Bafran/fall-detection-capstone/electrical/esp_module_rev1/symbols/BMP390L/10LGA_2X2X0p75_BOS.step

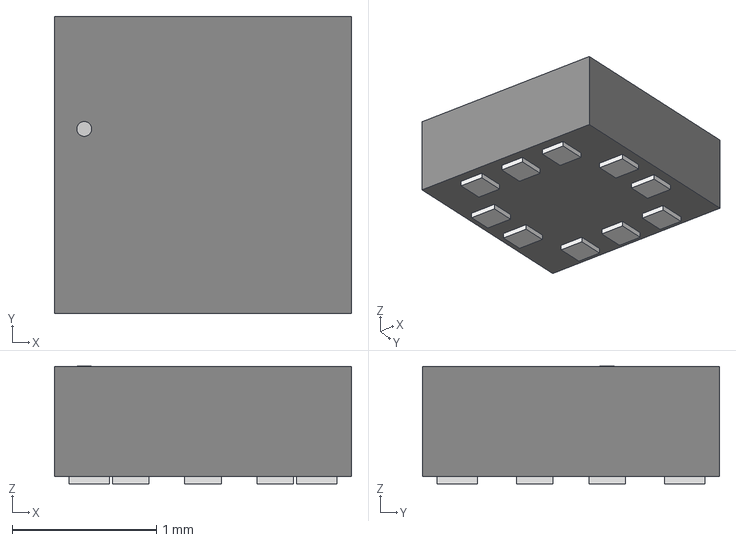
[picture p1: CAD file, 2025-12-22]
electrical/esp_module_rev1/symbols/BMP390L/10LGA_2X2X0p75_BOS.step
2.06 x 2.06 x 0.815 mm
