Bafran/fall-detection-capstone/electrical/symbols/TCK106AF/SMV_z90.stp

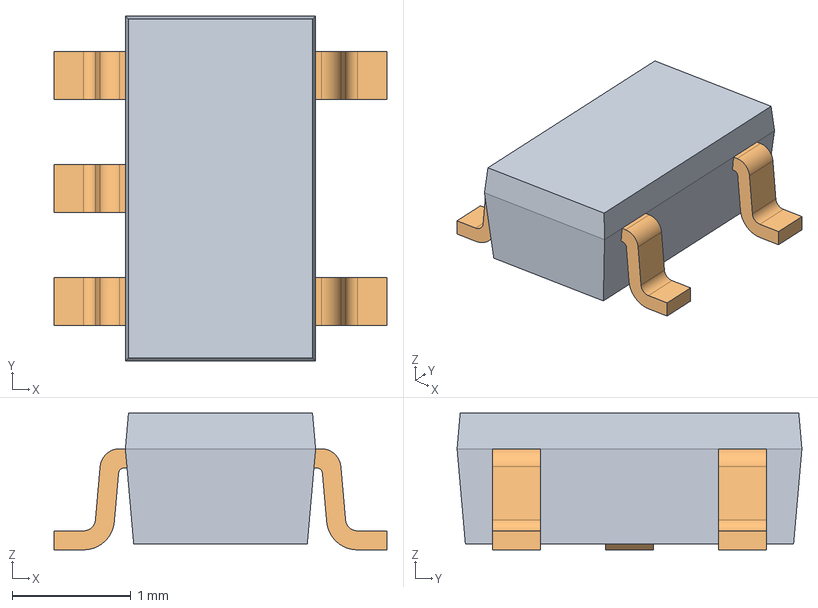
[picture p2: CAD file, 2025-12-19]
electrical/symbols/TCK106AF/SMV_z90.stp
2.80 x 2.90 x 1.15 mm
