Bafran/fall-detection-capstone/electrical/esp_module_rev1/esp_module_rev1/esp_module_rev1.kicad_pcb

## KiCad design electrical/esp_module_rev1/esp_module_rev1/esp_module_rev1.kicad_pcb (2026-01-17)

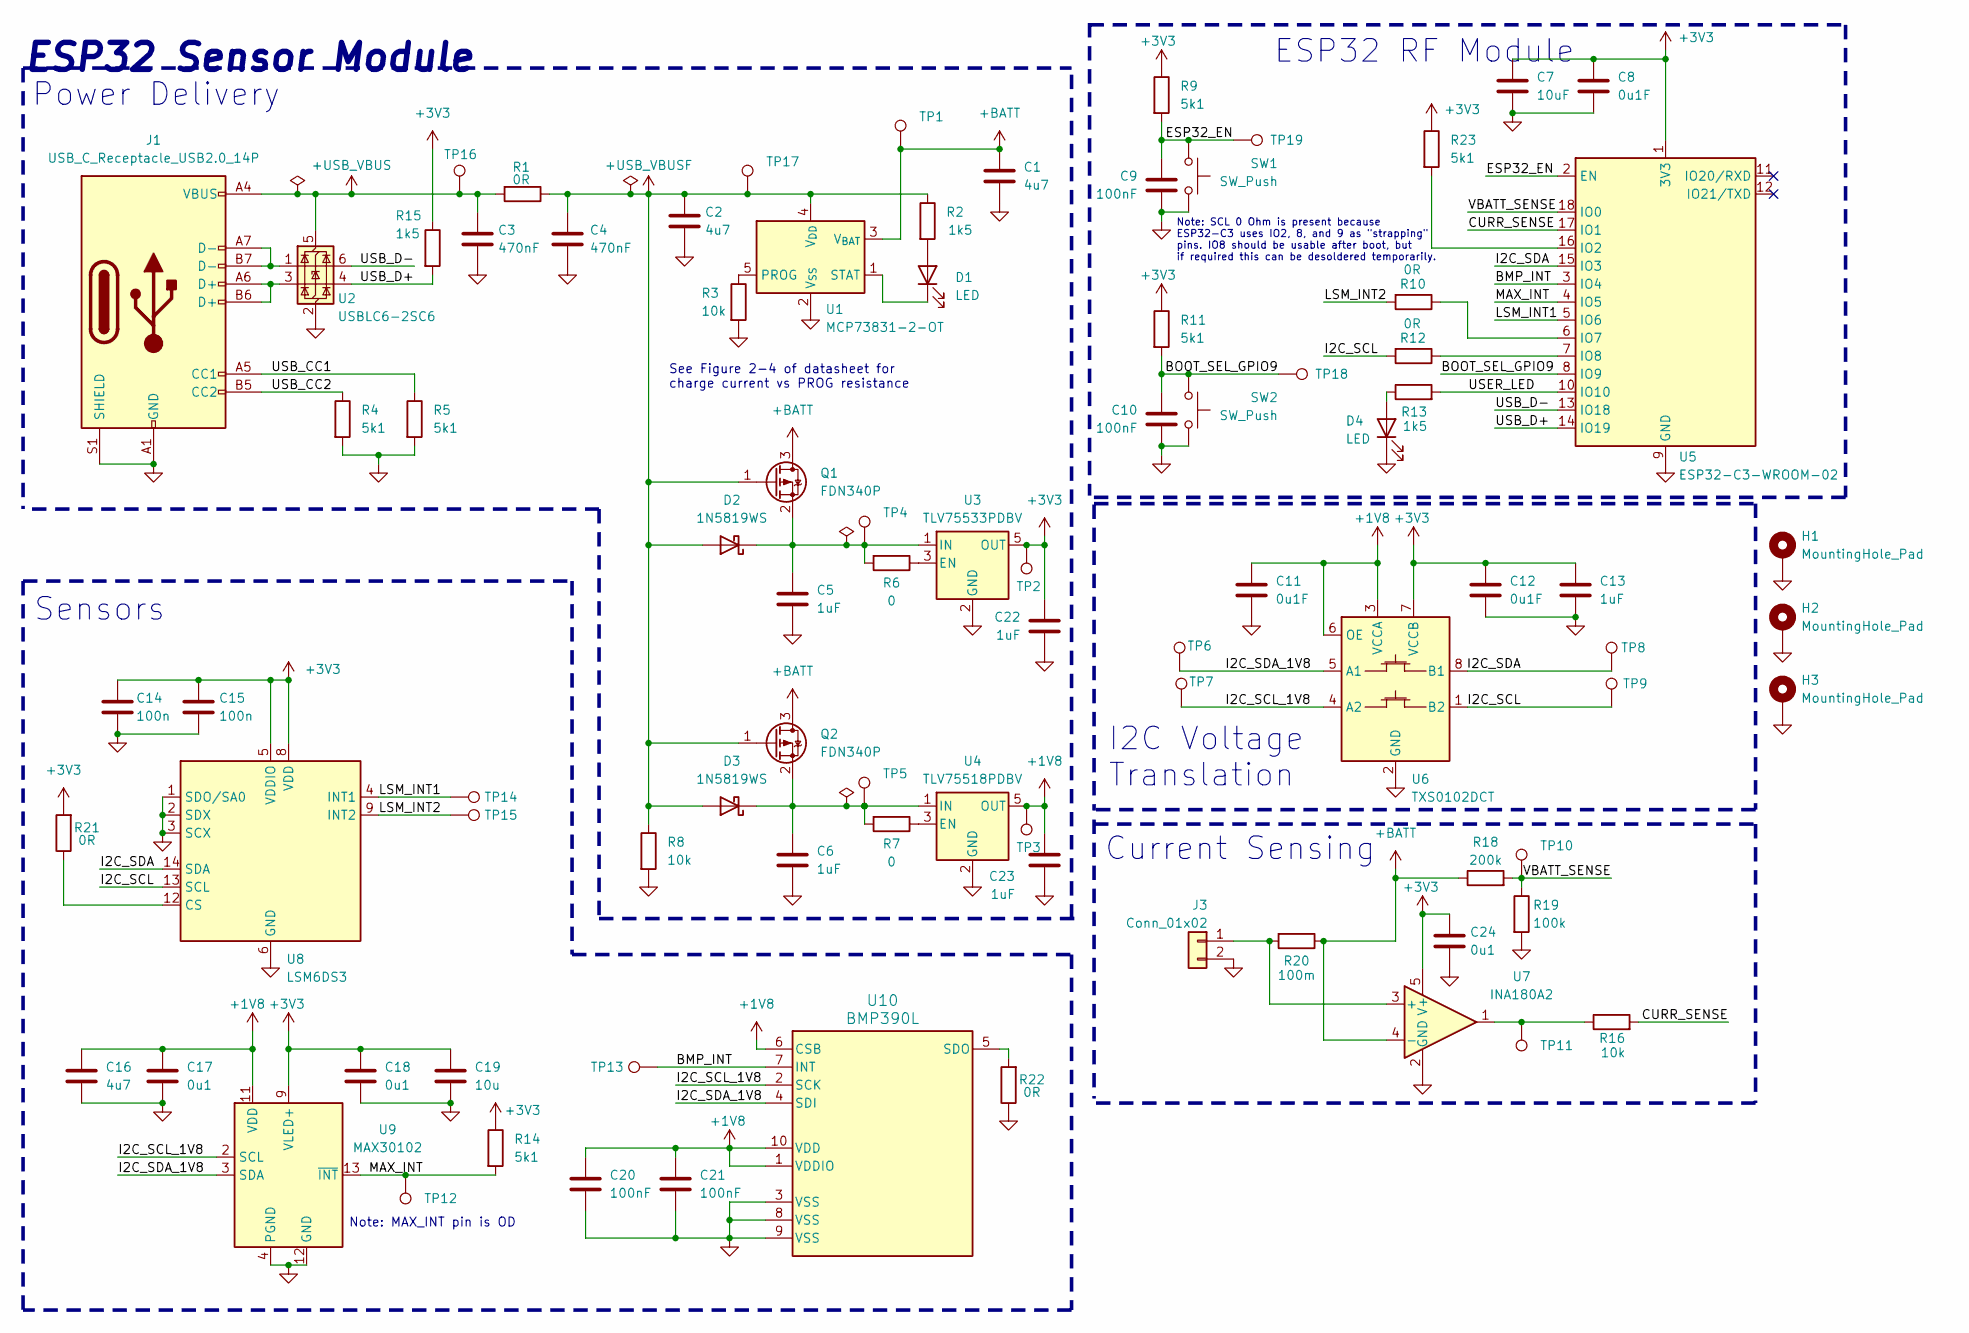
[picture p3: schematic esp_module_rev1.kicad_sch, ESP 32 Sensor Module]

Parts:
C1, C2, C16: 4u7; C_0603_1608Metric_Pad1.08x0.95mm_HandSolder
C3, C4: 470nF; C_0603_1608Metric_Pad1.08x0.95mm_HandSolder
C5, C6, C13, C22, C23: 1uF; C_0603_1608Metric_Pad1.08x0.95mm_HandSolder
C7: 10uF; C_0603_1608Metric_Pad1.08x0.95mm_HandSolder
C8, C11, C12: 0u1F; C_0603_1608Metric_Pad1.08x0.95mm_HandSolder
C9, C10, C20, C21: 100nF; C_0603_1608Metric_Pad1.08x0.95mm_HandSolder
C14, C15: 100n; C_0603_1608Metric_Pad1.08x0.95mm_HandSolder
C17, C18, C24: 0u1; C_0603_1608Metric_Pad1.08x0.95mm_HandSolder
C19: 10u; C_0603_1608Metric_Pad1.08x0.95mm_HandSolder
D1: LED; LED_0805_2012Metric_Pad1.15x1.40mm_HandSolder
D2, D3: 1N5819WS; D_SOD-323
D4: LED; LED_1206_3216Metric_Pad1.42x1.75mm_HandSolder
H1, H2, H3: MountingHole_Pad; MountingHole_2.2mm_M2_Pad_Via
J1: USB_C_Receptacle_USB2.0_14P; USB_C_Receptacle_GCT_USB4105-xx-A_16P_TopMnt_Horizontal
J3: Conn_01x02; JST_PH_B2B-PH-K_1x02_P2.00mm_Vertical
Q1, Q2: FDN340P; SOT-23
R1, R10, R12, R21, R22: 0R; R_0603_1608Metric_Pad0.98x0.95mm_HandSolder
R2, R13, R15: 1k5; R_0603_1608Metric_Pad0.98x0.95mm_HandSolder
R3, R8, R16: 10k; R_0603_1608Metric_Pad0.98x0.95mm_HandSolder
R4, R5, R9, R11, R14, R23: 5k1; R_0603_1608Metric_Pad0.98x0.95mm_HandSolder
R6, R7: 0; R_0603_1608Metric_Pad0.98x0.95mm_HandSolder
R18: 200k; R_0603_1608Metric_Pad0.98x0.95mm_HandSolder
R19: 100k; R_0603_1608Metric_Pad0.98x0.95mm_HandSolder
R20: 100m; R_0603_1608Metric_Pad0.98x0.95mm_HandSolder
SW1, SW2: SW_Push; SW_PUSH_6mm
TP1, TP2, TP3, TP4, TP5, TP6, TP7, TP8, TP9, TP10, TP11, TP12, TP13, TP14, TP15, TP16, TP17, TP18, TP19: TestPoint; TestPoint_THTPad_D1.5mm_Drill0.7mm
U1: MCP73831-2-OT; SOT-23-5
U2: USBLC6-2SC6; SOT-23-6
U3: TLV75533PDBV; SOT-23-5
U4: TLV75518PDBV; SOT-23-5
U5: ESP32-C3-WROOM-02
U6: TXS0102DCT; SSOP-8_2.95x2.8mm_P0.65mm
U7: INA180A2; SOT-23-5
U8: LSM6DS3; LGA-14_3x2.5mm_P0.5mm_LayoutBorder3x4y
U9: MAX30102; Maxim_OLGA-14_3.3x5.6mm_P0.8mm
U10: BMP390L; 10LGA_2X2X0p75_BOS

Connections:
+1V8: C11.1, C16.1, C17.1, C20.1, C21.1, C23.1, TP3.1, U4.5 (OUT), U6.3 (VCCA), U6.6 (OE), U9.11 (VDD), U10.1 (VDDIO), U10.6 (CSB), U10.10 (VDD)
+3V3: C7.1, C8.1, C12.1, C13.1, C14.1, C15.1, C18.1, C19.1, C22.1, C24.1, R9.1, R11.1, R14.1, R15.1, R21.2, R23.1, TP2.1, U3.5 (OUT), U5.1 (3V3), U6.7 (VCCB), U7.5 (V+), U8.5 (VDDIO), U8.8 (VDD), U9.9 (VLED+), U9.10 (VLED+)
+BATT: C1.1, Q1.3 (D), Q2.3 (D), R18.1, R20.1, TP1.1, U1.3 (V_{BAT}), U7.4 (-)
+USB_VBUS: C3.1, J1.A4 (VBUS), J1.A9 (VBUS), J1.B4 (VBUS), J1.B9 (VBUS), R1.2, TP16.1, U2.5 (VBUS)
+USB_VBUSF: C2.1, C4.1, D2.2 (A), D3.2 (A), Q1.1 (G), Q2.1 (G), R1.1, R2.1, R8.1, TP17.1, U1.4 (V_{DD})
/BMP_INT: TP13.1, U5.3 (IO4), U10.7 (INT)
/BOOT_SEL_GPIO9: C10.1, R11.2, SW2.2, TP18.1, U5.8 (IO9)
/CURR_SENSE: R16.2, U5.17 (IO1)
/ESP32_EN: C9.1, R9.2, SW1.2, TP19.1, U5.2 (EN)
/I2C_SCL: R12.2, TP9.1, U6.1 (B2), U8.13 (SCL)
/I2C_SCL_1V8: TP7.1, U6.4 (A2), U9.2 (SCL), U10.2 (SCK)
/I2C_SDA: TP8.1, U5.15 (IO3), U6.8 (B1), U8.14 (SDA)
/I2C_SDA_1V8: TP6.1, U6.5 (A1), U9.3 (SDA), U10.4 (SDI)
/LSM_INT1: TP14.1, U5.5 (IO6), U8.4 (INT1)
/LSM_INT2: R10.2, TP15.1, U8.9 (INT2)
/MAX_INT: R14.2, TP12.1, U5.4 (IO5), U9.13 (~INT)
/USB_CC1: J1.A5 (CC1), R5.1
/USB_CC2: J1.B5 (CC2), R4.1
/USB_D+: R15.2, U2.4 (I/O2), U5.14 (IO19)
/USB_D-: U2.6 (I/O1), U5.13 (IO18)
/USER_LED: R13.2, U5.10 (IO10)
/VBATT_SENSE: R18.2, R19.1, TP10.1, U5.18 (IO0)
GND: C1.2, C2.2, C3.2, C4.2, C5.2, C6.2, C7.2, C8.2, C9.2, C10.2, C11.2, C12.2, C13.2, C14.2, C15.2, C16.2, C17.2, C18.2, C19.2, C20.2, C21.2, C22.2, C23.2, C24.2, D4.1 (K), H1.1, H2.1, H3.1, J1.A1 (GND), J1.A12 (GND), J1.B1 (GND), J1.B12 (GND), J1.S1 (SHIELD), J3.2, R3.2, R4.2, R5.2, R8.2, R19.2, R22.1, SW1.1, SW2.1, U1.2 (V_{SS}), U2.2 (GND), U3.2 (GND), U4.2 (GND), U5.9 (GND), U5.19 (GND), U6.2 (GND), U7.2 (GND), U8.1 (SDO/SA0), U8.2 (SDX), U8.3 (SCX), U8.6 (GND), U8.7 (GND), U9.4 (PGND), U9.12 (GND), U10.3 (VSS), U10.8 (VSS), U10.9 (VSS)
unnamed: D1.2 (A), R2.2
unnamed: D1.1 (K), U1.1 (STAT)
unnamed: C5.1, D2.1 (K), Q1.2 (S), R6.2, TP4.1, U3.1 (IN)
unnamed: C6.1, D3.1 (K), Q2.2 (S), R7.2, TP5.1, U4.1 (IN)
unnamed: D4.2 (A), R13.1
unnamed: J1.A6 (D+), J1.B6 (D+), U2.3 (I/O2)
unnamed: J1.A7 (D-), J1.B7 (D-), U2.1 (I/O1)
unnamed: J3.1, R20.2, U7.3 (+)
unnamed: R16.1, TP11.1, U7.1
unnamed: R3.1, U1.5 (PROG)
unnamed: R6.1, U3.3 (EN)
unnamed: R7.1, U4.3 (EN)
unnamed: R23.2, U5.16 (IO2)
unnamed: R10.1, U5.6 (IO7)
unnamed: R12.1, U5.7 (IO8)
unnamed: R21.1, U8.12 (CS)
unnamed: R22.2, U10.5 (SDO)

Notes on the sheet:
Power Delivery
Sensors
Note: SCL 0 Ohm is present because ESP32-C3 uses IO2, 8, and 9 as "strapping" pins. IO8 should be usable after boot, but if required this can be desoldered temporarily.
Note: MAX_INT pin is OD
See Figure 2-4 of datasheet for charge current vs PROG resistance
I2C Voltage Translation
ESP32 RF Module
ESP32 Sensor Module
Current Sensing

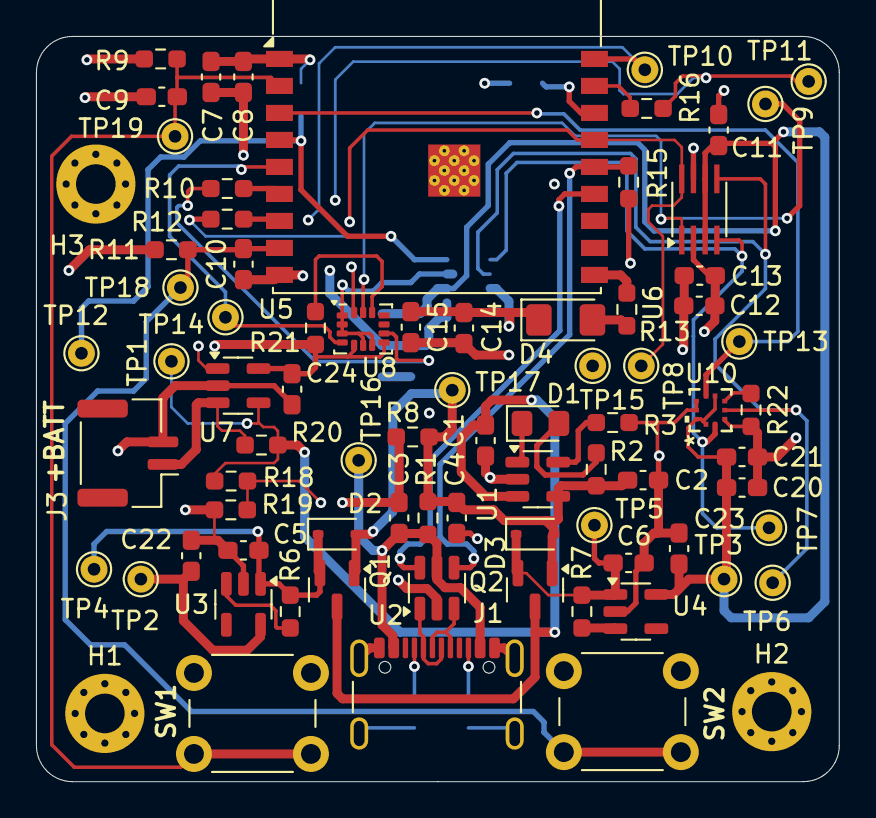
[picture p4: board esp_module_rev1.kicad_pcb from above]

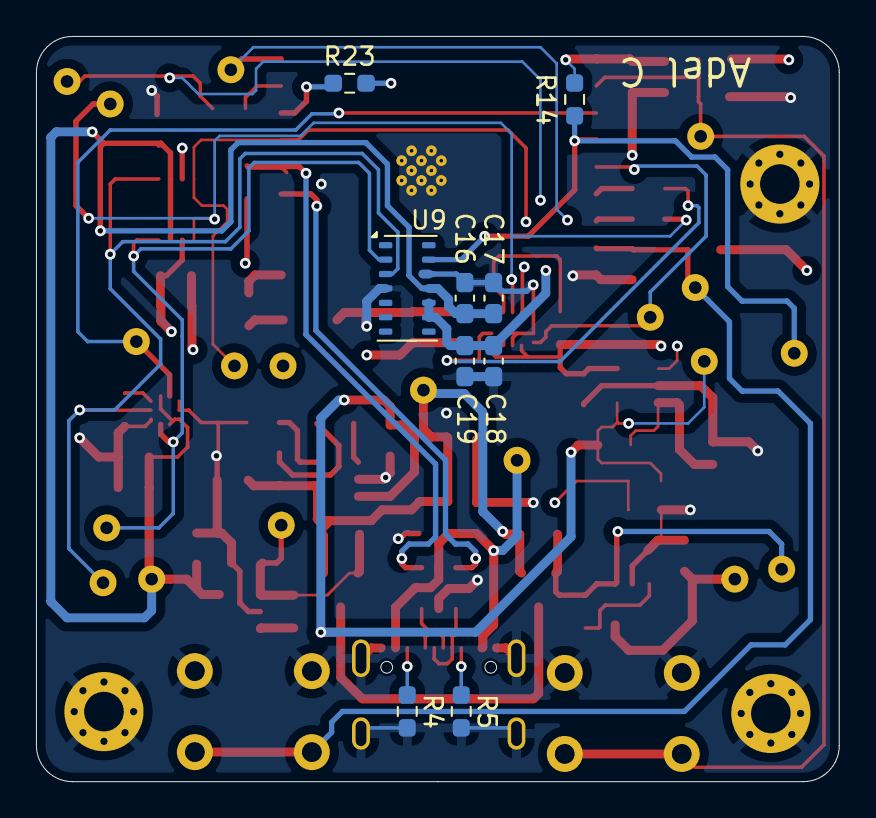
[picture p5: board esp_module_rev1.kicad_pcb from below]

Board: 4 copper layers, 44.6 x 41.4 mm, 88 parts (9 on the bottom side), 40 nets.
