Bafran/fall-detection-capstone/electrical/bracelet_rev1/bracelet_rev1.kicad_pcb

## KiCad design electrical/bracelet_rev1/bracelet_rev1.kicad_pcb (2025-12-21)

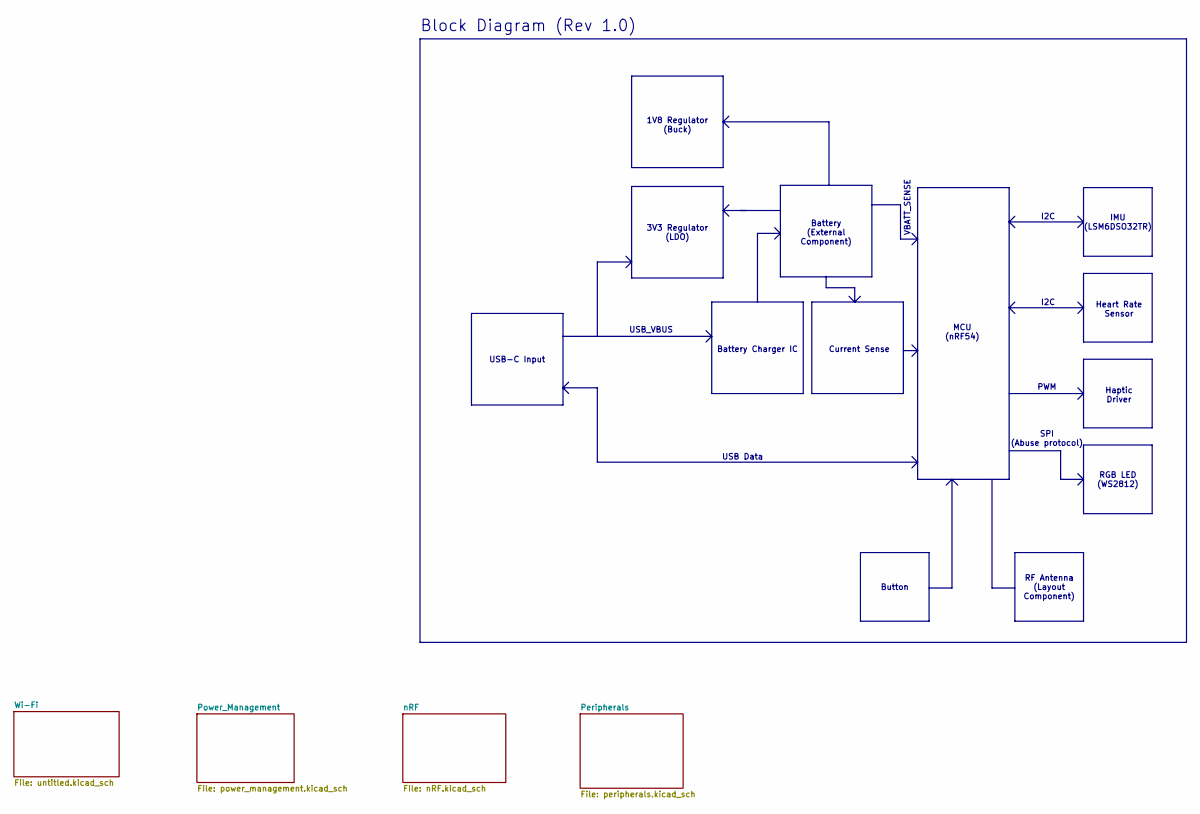
[picture p6: schematic bracelet_rev1.kicad_sch]

Notes on the sheet:
VBATT_SENSE
I2C
3V3 Regulator (LDO)
Haptic Driver
RGB LED (WS2812)
USB Data
Current Sense
IMU (LSM6DSO32TR)
SPI (Abuse protocol)
MCU (nRF54)
USB_VBUS
1V8 Regulator (Buck)
RF Antenna (Layout Component)
Block Diagram (Rev 1.0)
Button
Battery (External Component)
PWM
Battery Charger IC
Heart Rate Sensor
USB-C Input

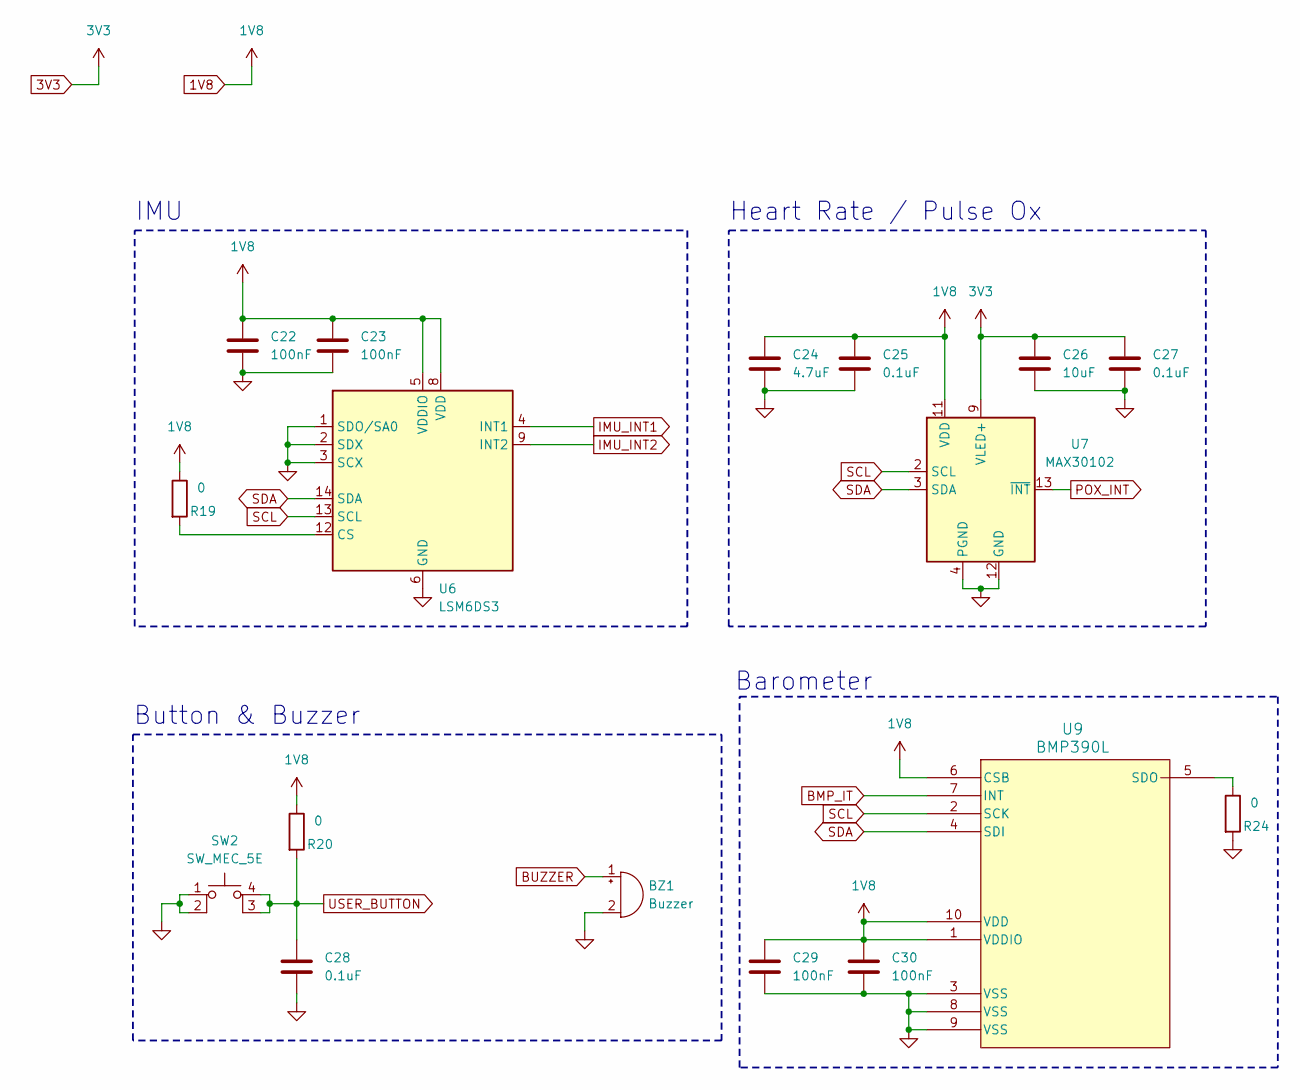
[picture p7: schematic peripherals.kicad_sch]

Parts:
BZ1: Buzzer
C22, C23, C29, C30: 100nF; C_0603_1608Metric_Pad1.08x0.95mm_HandSolder
C24: 4.7uF; C_0603_1608Metric_Pad1.08x0.95mm_HandSolder
C25, C27, C28: 0.1uF; C_0603_1608Metric_Pad1.08x0.95mm_HandSolder
C26: 10uF; C_0603_1608Metric_Pad1.08x0.95mm_HandSolder
R19, R20: 0; R_0603_1608Metric_Pad0.98x0.95mm_HandSolder
R24: 0; R_0201_0603Metric_Pad0.64x0.40mm_HandSolder
SW2: SW_MEC_5E; SW_MEC_5GSH9
U6: LSM6DS3; LGA-14_3x2.5mm_P0.5mm_LayoutBorder3x4y
U7: MAX30102; Maxim_OLGA-14_3.3x5.6mm_P0.8mm
U9: BMP390L

Connections:
3V3: C26.1, C27.1, U7.9 (VLED+), U7.10 (VLED+); also elsewhere on the board
GND: BZ1.2 (-), C22.2, C23.2, C24.2, C25.2, C26.2, C27.2, C28.2, C29.2, C30.2, R24.2, SW2.1, SW2.2, U6.1 (SDO/SA0), U6.2 (SDX), U6.3 (SCX), U6.6 (GND), U6.7 (GND), U7.4 (PGND), U7.12 (GND), U9.3 (VSS), U9.8 (VSS), U9.9 (VSS); also elsewhere on the board
IMU_INT1: U6.4 (INT1); also elsewhere on the board
IMU_INT2: U6.9 (INT2); also elsewhere on the board
unnamed: R19.2, U6.12 (CS)
unnamed: R24.1, U9.5 (SDO)
POX_INT: U7.13 (~INT); also elsewhere on the board
SCL: U6.13 (SCL), U7.2 (SCL), U9.2 (SCK); also elsewhere on the board
SDA: U6.14 (SDA), U7.3 (SDA), U9.4 (SDI); also elsewhere on the board
USER_BUTTON: C28.1, R20.2, SW2.3 (K), SW2.4 (A); also elsewhere on the board

Notes on the sheet:
Button & Buzzer
Heart Rate / Pulse Ox
IMU
Barometer

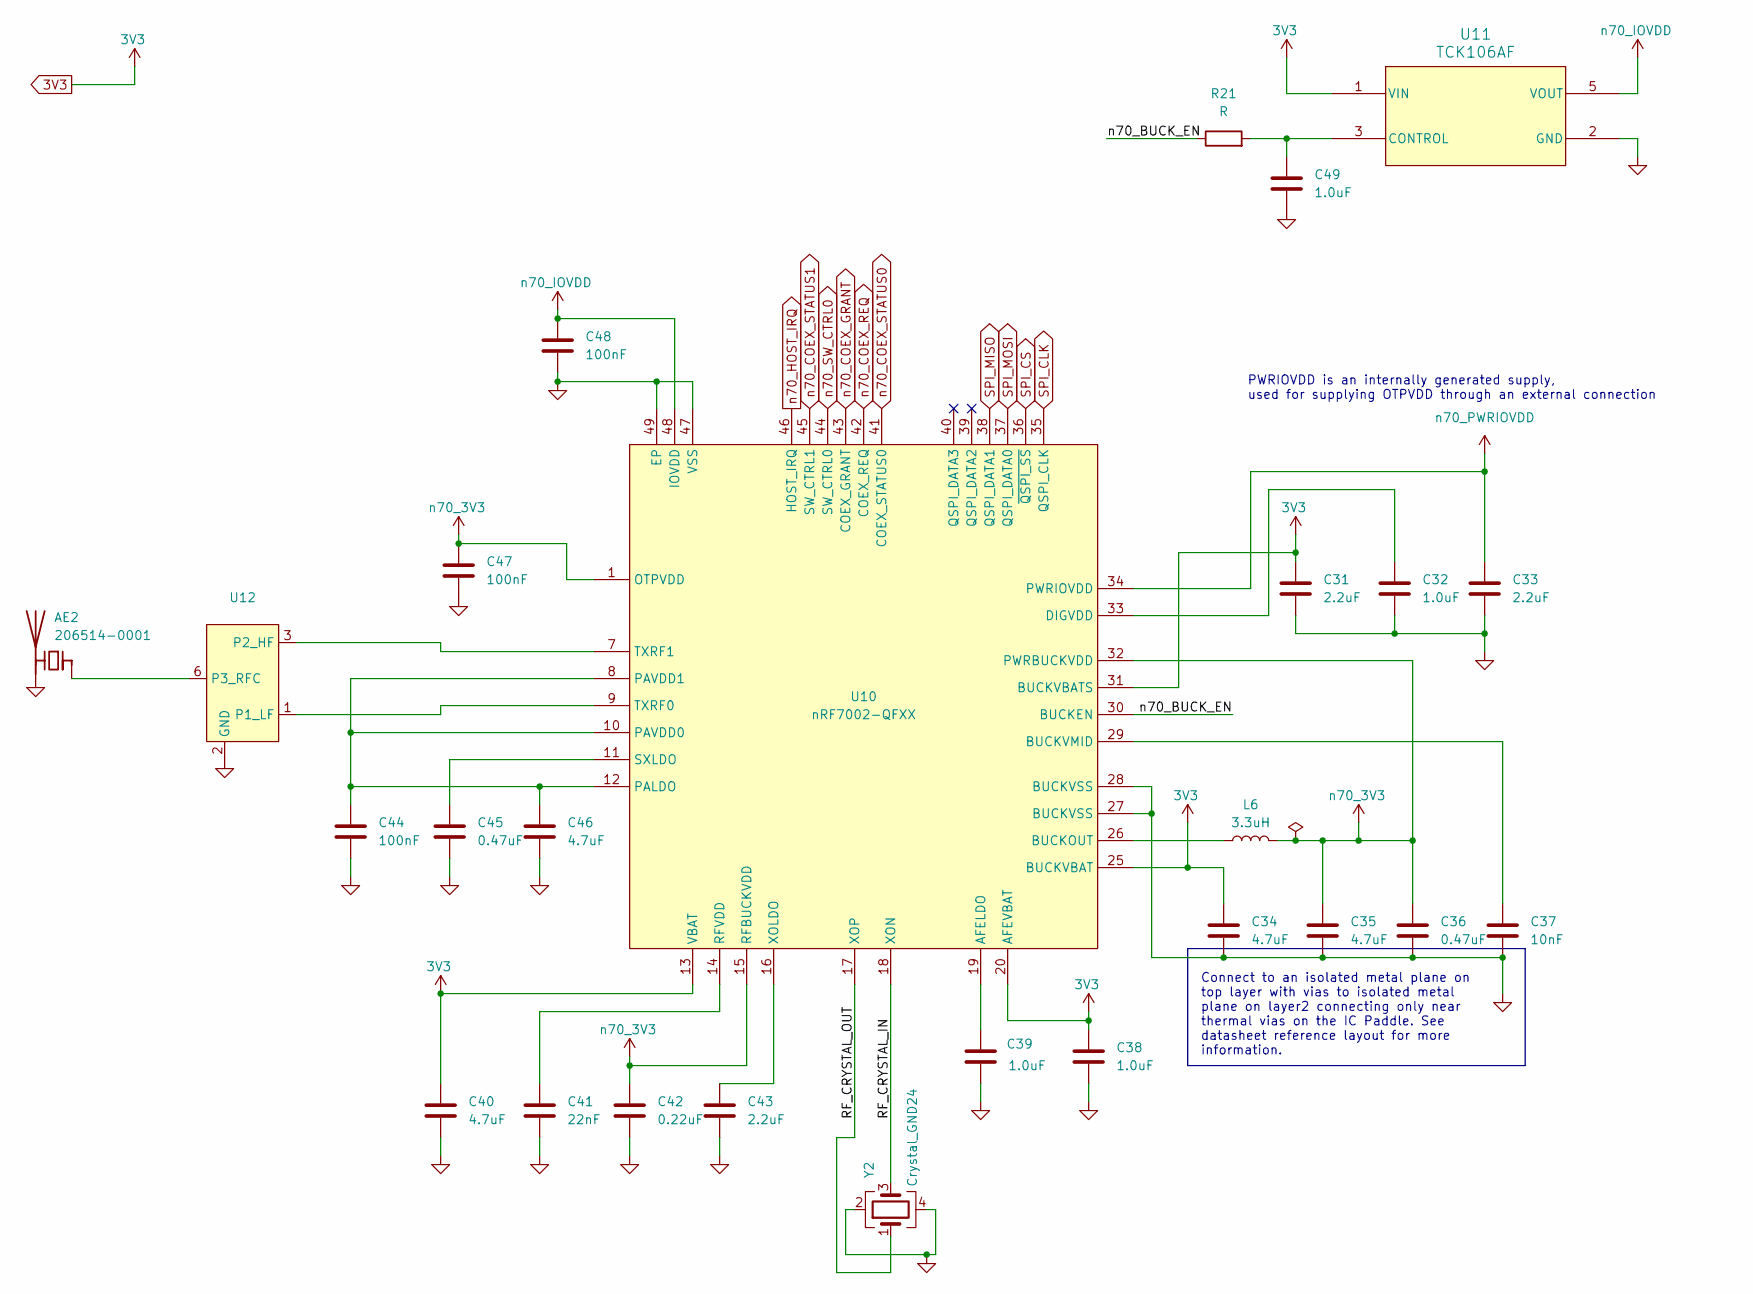
[picture p8: schematic untitled.kicad_sch]

Parts:
AE2: 206514-0001
C31, C33, C43: 2.2uF; C_0603_1608Metric_Pad1.08x0.95mm_HandSolder
C32, C38, C39, C49: 1.0uF; C_0603_1608Metric_Pad1.08x0.95mm_HandSolder
C34, C35, C40, C46: 4.7uF; C_0603_1608Metric_Pad1.08x0.95mm_HandSolder
C36, C45: 0.47uF; C_0603_1608Metric_Pad1.08x0.95mm_HandSolder
C37: 10nF; C_0603_1608Metric_Pad1.08x0.95mm_HandSolder
C41: 22nF; C_0603_1608Metric_Pad1.08x0.95mm_HandSolder
C42: 0.22uF; C_0603_1608Metric_Pad1.08x0.95mm_HandSolder
C44, C47, C48: 100nF; C_0603_1608Metric_Pad1.08x0.95mm_HandSolder
L6: 3.3uH; L_0603_1608Metric_Pad1.05x0.95mm_HandSolder
R21: R; R_0201_0603Metric_Pad0.64x0.40mm_HandSolder
U10: nRF7002-QFXX; QFN-48-1EP_6x6mm_P0.4mm_EP4.6x4.6mm_ThermalVias
U11: TCK106AF
U12: (no value)
Y2: Crystal_GND24; Crystal_SMD_3225-4Pin_3.2x2.5mm_HandSoldering

Connections:
3V3: C31.1, C34.1, C38.1, C40.1, U10.13 (VBAT), U10.20 (AFEVBAT), U10.25 (BUCKVBAT), U10.31 (BUCKVBATS), U11.1 (VIN); also elsewhere on the board
/Wi-Fi/RF_CRYSTAL_IN: U10.18 (XON), Y2.3
/Wi-Fi/RF_CRYSTAL_OUT: U10.17 (XOP), Y2.1
/Wi-Fi/n70_BUCK_EN: R21.1, U10.30 (BUCKEN)
GND: AE2.2 (PCB_Trace), C31.2, C32.2, C33.2, C34.2, C35.2, C36.2, C37.2, C38.2, C39.2, C40.2, C41.2, C42.2, C43.2, C44.2, C45.2, C46.2, C47.2, C48.2, C49.2, U10.27 (BUCKVSS), U10.28 (BUCKVSS), U10.47 (VSS), U10.49 (EP), U11.2 (GND), U12.2 (GND), U12.5 (GND), U12.7 (GND), Y2.2, Y2.4; also elsewhere on the board
unnamed: AE2.1 (FEED), U12.6 (P3_RFC)
unnamed: C39.1, U10.19 (AFELDO)
unnamed: L6.1, U10.26 (BUCKOUT)
unnamed: C37.1, U10.29 (BUCKVMID)
unnamed: C32.1, U10.33 (DIGVDD)
unnamed: C44.1, C46.1, U10.8 (PAVDD1), U10.10 (PAVDD0), U10.12 (PALDO)
unnamed: C41.1, U10.14 (RFVDD)
unnamed: C45.1, U10.11 (SXLDO)
unnamed: U10.9 (TXRF0), U12.1 (P1_LF)
unnamed: U10.7 (TXRF1), U12.3 (P2_HF)
unnamed: C43.1, U10.16 (XOLDO)
unnamed: C49.1, R21.2, U11.3 (CONTROL)
SPI_CLK: U10.35 (QSPI_CLK); also elsewhere on the board
SPI_CS: U10.36 (~QSPI_SS); also elsewhere on the board
SPI_MISO: U10.38 (QSPI_DATA1); also elsewhere on the board
SPI_MOSI: U10.37 (QSPI_DATA0); also elsewhere on the board
n70_3V3: C35.1, C36.1, C42.1, C47.1, L6.2, U10.1 (OTPVDD), U10.15 (RFBUCKVDD), U10.32 (PWRBUCKVDD)
n70_COEX_GRANT: U10.43 (COEX_GRANT); also elsewhere on the board
n70_COEX_REQ: U10.42 (COEX_REQ); also elsewhere on the board
n70_COEX_STATUS0: U10.41 (COEX_STATUS0); also elsewhere on the board
n70_COEX_STATUS1: U10.45 (SW_CTRL1); also elsewhere on the board
n70_HOST_IRQ: U10.46 (HOST_IRQ); also elsewhere on the board
n70_IOVDD: C48.1, U10.48 (IOVDD), U11.5 (VOUT)
n70_PWRIOVDD: C33.1, U10.34 (PWRIOVDD)
n70_SW_CTRL0: U10.44 (SW_CTRL0); also elsewhere on the board

Notes on the sheet:
PWRIOVDD is an internally generated supply, used for supplying OTPVDD through an external connection
Connect to an isolated metal plane on top layer with vias to isolated metal plane on layer2 connecting only near thermal vias on the IC Paddle. See datasheet reference layout for more information.

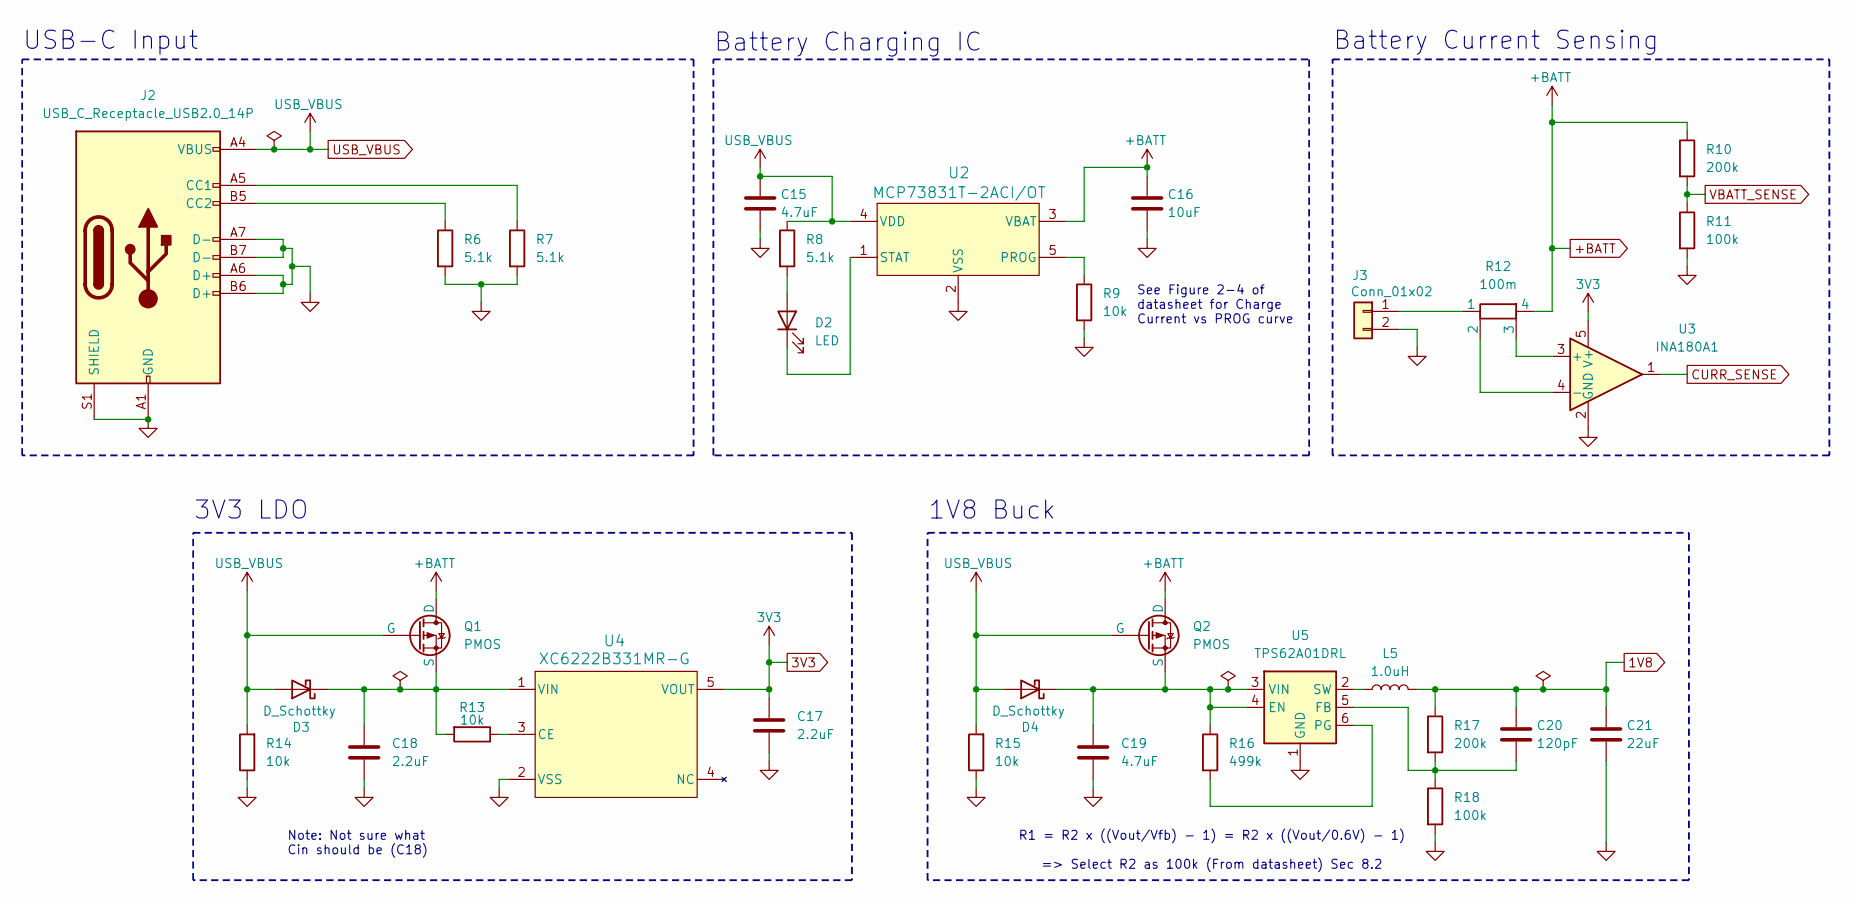
[picture p9: schematic power_management.kicad_sch]

Parts:
C15, C19: 4.7uF; C_0603_1608Metric_Pad1.08x0.95mm_HandSolder
C16: 10uF; C_0603_1608Metric_Pad1.08x0.95mm_HandSolder
C17, C18: 2.2uF; C_0603_1608Metric_Pad1.08x0.95mm_HandSolder
C20: 120pF; C_0603_1608Metric_Pad1.08x0.95mm_HandSolder
C21: 22uF; C_0603_1608Metric_Pad1.08x0.95mm_HandSolder
D2: LED; LED_0603_1608Metric_Pad1.05x0.95mm_HandSolder
D3, D4: D_Schottky; D_0603_1608Metric_Pad1.05x0.95mm_HandSolder
J2: USB_C_Receptacle_USB2.0_14P
J3: Conn_01x02; JST_PH_B2B-PH-K_1x02_P2.00mm_Vertical
L5: 1.0uH; L_0603_1608Metric_Pad1.05x0.95mm_HandSolder
Q1, Q2: PMOS; SOT-23-3
R6, R7, R8: 5.1k; R_0603_1608Metric_Pad0.98x0.95mm_HandSolder
R9, R13, R14, R15: 10k; R_0603_1608Metric_Pad0.98x0.95mm_HandSolder
R10, R17: 200k; R_0603_1608Metric_Pad0.98x0.95mm_HandSolder
R11, R18: 100k; R_0603_1608Metric_Pad0.98x0.95mm_HandSolder
R12: 100m; R_Shunt_Ohmite_LVK12
R16: 499k; R_0603_1608Metric_Pad0.98x0.95mm_HandSolder
U2: MCP73831T-2ACI/OT
U3: INA180A1; SOT-23-5
U4: XC6222B331MR-G
U5: TPS62A01DRL; SOT-563

Connections:
3V3: C17.1, U2.6 (V_{CCB}), U3.5 (V+), U4.5 (VOUT); also elsewhere on the board
CURR_SENSE: U3.1; also elsewhere on the board
GND: C15.2, C16.2, C17.2, C18.2, C19.2, C21.2, J2.A1 (GND), J2.A6 (D+), J2.A7 (D-), J2.A12 (GND), J2.B1 (GND), J2.B6 (D+), J2.B7 (D-), J2.B12 (GND), J2.S1 (SHIELD), J3.2, R6.2, R7.2, R9.2, R11.2, R14.1, R15.1, R18.2, U2.2 (GND), U3.2 (GND), U4.2 (VSS), U5.1 (GND); also elsewhere on the board
unnamed: D2.2 (A), R8.2
unnamed: C18.1, D3.1 (K), Q1.3 (S), R13.2, U4.1 (VIN)
unnamed: C19.1, D4.1 (K), Q2.3 (S), R16.1, U5.3 (VIN), U5.4 (EN)
unnamed: J2.A5 (CC1), R7.1
unnamed: J2.B5 (CC2), R6.1
unnamed: J3.1, R12.1
unnamed: R12.3, U3.3 (+)
unnamed: R12.2, U3.4 (-)
unnamed: R13.1, U4.3 (CE)
unnamed: C20.2, R17.2, R18.1, U5.5 (FB)
unnamed: R16.2, U5.6 (PG)
unnamed: L5.1, U5.2 (SW)
VBATT_SENSE: R10.2, R11.1; also elsewhere on the board

Notes on the sheet:
R1 = R2 x ((Vout/Vfb) - 1) = R2 x ((Vout/0.6V) - 1) => Select R2 as 100k (From datasheet) Sec 8.2
Note: Not sure what Cin should be (C18)
See Figure 2-4 of datasheet for Charge Current vs PROG curve
3V3 LDO
1V8 Buck
Battery Current Sensing
USB-C Input
Battery Charging IC

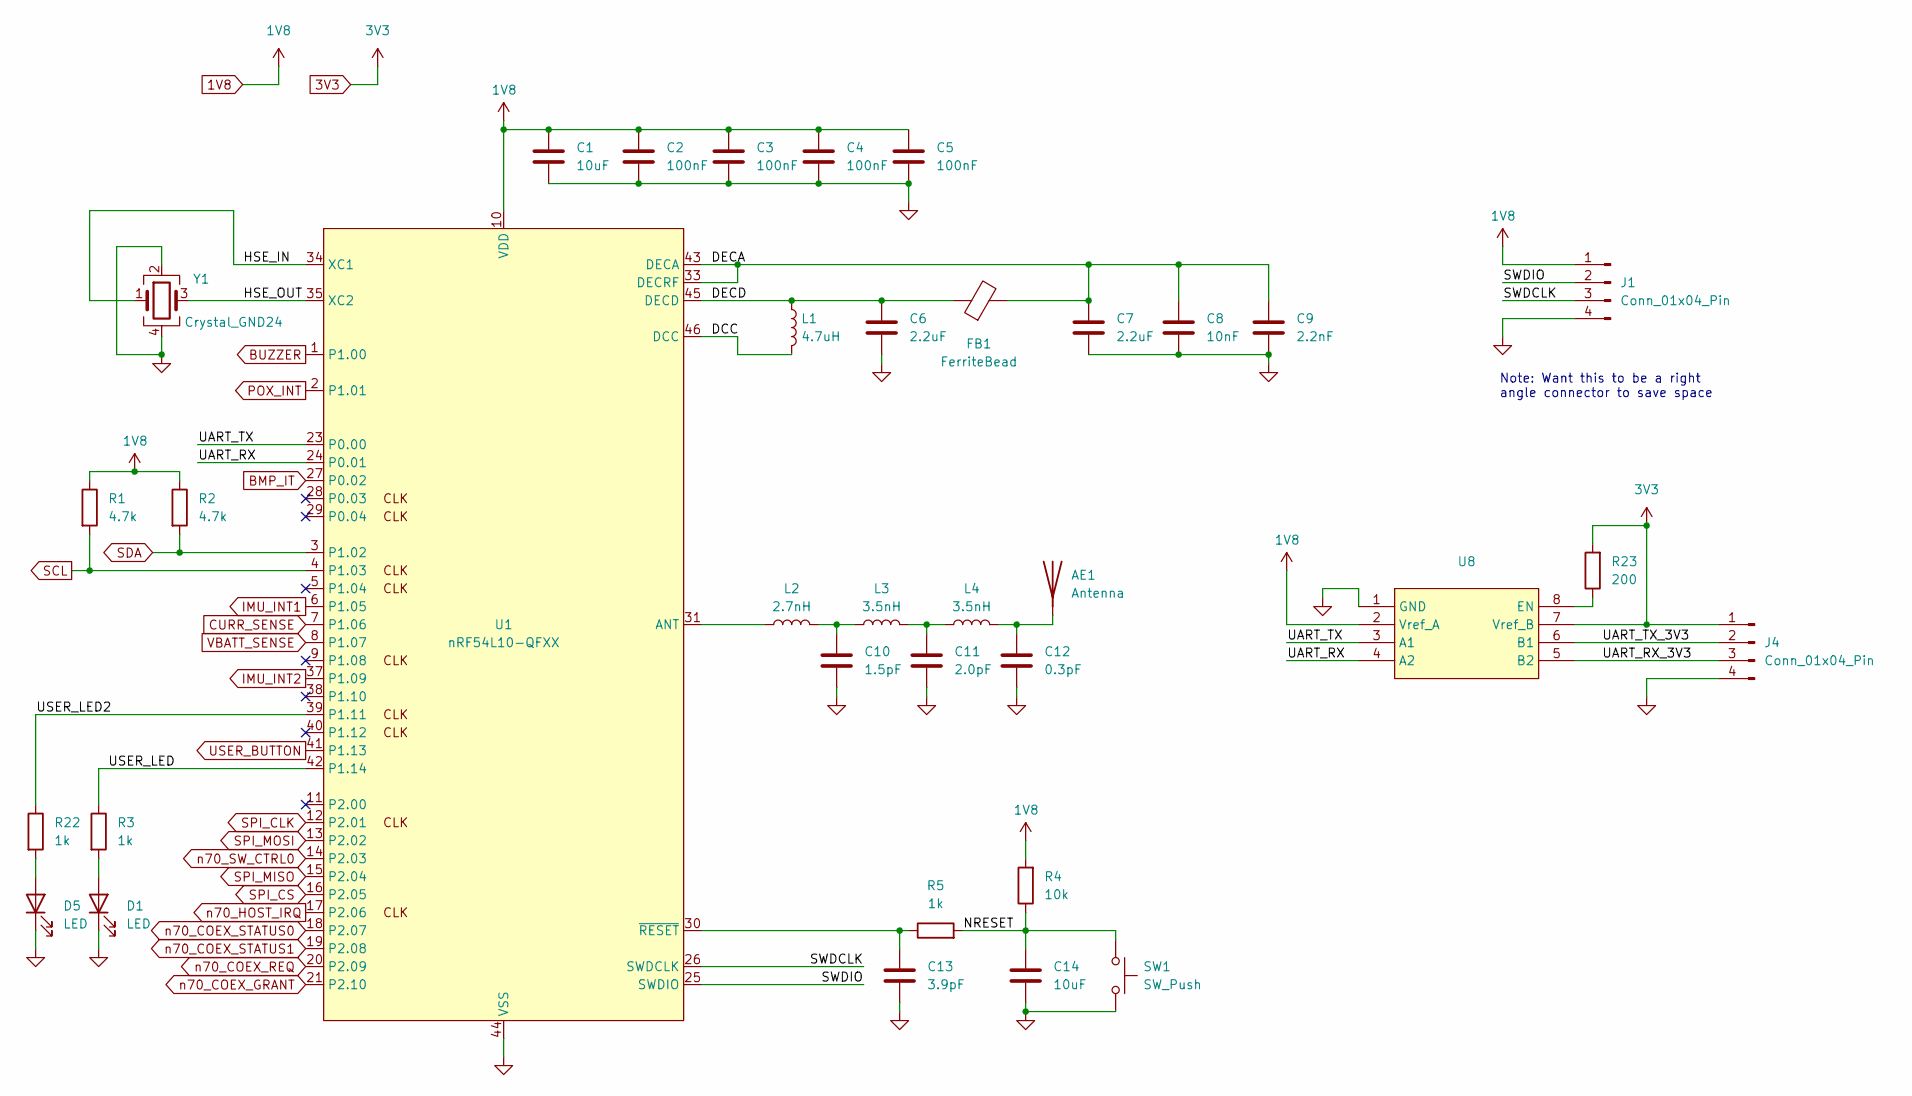
[picture p10: schematic nRF.kicad_sch]

Parts:
AE1: Antenna
C1, C14: 10uF; C_0603_1608Metric_Pad1.08x0.95mm_HandSolder
C2, C3, C4, C5: 100nF; C_0603_1608Metric_Pad1.08x0.95mm_HandSolder
C6, C7: 2.2uF; C_0603_1608Metric_Pad1.08x0.95mm_HandSolder
C8: 10nF; C_0603_1608Metric_Pad1.08x0.95mm_HandSolder
C9: 2.2nF; C_0603_1608Metric_Pad1.08x0.95mm_HandSolder
C10: 1.5pF; C_0603_1608Metric_Pad1.08x0.95mm_HandSolder
C11: 2.0pF; C_0603_1608Metric_Pad1.08x0.95mm_HandSolder
C12: 0.3pF; C_0603_1608Metric_Pad1.08x0.95mm_HandSolder
C13: 3.9pF; C_0603_1608Metric_Pad1.08x0.95mm_HandSolder
D1, D5: LED; LED_0603_1608Metric_Pad1.05x0.95mm_HandSolder
FB1: FerriteBead; L_0603_1608Metric_Pad1.05x0.95mm_HandSolder
J1, J4: Conn_01x04_Pin; PinHeader_1x04_P2.54mm_Vertical
L1: 4.7uH; L_0603_1608Metric_Pad1.05x0.95mm_HandSolder
L2: 2.7nH; L_0603_1608Metric_Pad1.05x0.95mm_HandSolder
L3, L4: 3.5nH; L_0603_1608Metric_Pad1.05x0.95mm_HandSolder
R1, R2: 4.7k; R_0603_1608Metric_Pad0.98x0.95mm_HandSolder
R3, R5: 1k; R_0603_1608Metric_Pad0.98x0.95mm_HandSolder
R4: 10k; R_0603_1608Metric_Pad0.98x0.95mm_HandSolder
R22: 1k; R_0201_0603Metric_Pad0.64x0.40mm_HandSolder
R23: 200; R_0201_0603Metric_Pad0.64x0.40mm_HandSolder
SW1: SW_Push
U1: nRF54L10-QFXX; QFN-48-1EP_6x6mm_P0.4mm_EP4.6x4.6mm
U8: (no value)
Y1: Crystal_GND24; Crystal_SMD_3225-4Pin_3.2x2.5mm_HandSoldering

Connections:
3V3: J4.1, R23.2, U8.7 (Vref_B); also elsewhere on the board
/nRF/DCC: L1.2, U1.46 (DCC)
/nRF/DECA: C7.1, C8.1, C9.1, FB1.2, U1.33 (DECRF), U1.43 (DECA)
/nRF/DECD: C6.1, FB1.1, L1.1, U1.45 (DECD)
/nRF/HSE_IN: U1.34 (XC1), Y1.1
/nRF/HSE_OUT: U1.35 (XC2), Y1.3
/nRF/NRESET: C14.1, R4.1, R5.2, SW1.1
/nRF/SWDCLK: J1.3, U1.26 (SWDCLK)
/nRF/SWDIO: J1.2, U1.25 (SWDIO)
/nRF/UART_RX: U1.24 (P0.01), U8.4 (A2)
/nRF/UART_RX_3V3: J4.3, U8.5 (B2)
/nRF/UART_TX: U1.23 (P0.00), U8.3 (A1)
/nRF/UART_TX_3V3: J4.2, U8.6 (B1)
/nRF/USER_LED: R3.1, U1.42 (P1.14)
/nRF/USER_LED2: R22.1, U1.39 (P1.11)
BMP_IT: U1.27 (P0.02)
BUZZER: U1.1 (P1.00)
CURR_SENSE: U1.7 (P1.06); also elsewhere on the board
GND: C1.2, C2.2, C3.2, C4.2, C5.2, C6.2, C7.2, C8.2, C9.2, C10.2, C11.2, C12.2, C13.2, C14.2, D1.1 (K), D5.1 (K), J1.4, J4.4, SW1.2, U1.32 (VSS_PA), U1.44 (VSS), U1.49 (VSS), U8.1 (GND), Y1.2, Y1.4; also elsewhere on the board
IMU_INT1: U1.6 (P1.05); also elsewhere on the board
IMU_INT2: U1.37 (P1.09); also elsewhere on the board
unnamed: AE1.1, C12.1, L4.2
unnamed: C10.1, L2.2, L3.1
unnamed: C11.1, L3.2, L4.1
unnamed: D1.2 (A), R3.2
unnamed: D5.2 (A), R22.2
unnamed: L2.1, U1.31 (ANT)
unnamed: C13.1, R5.1, U1.30 (~RESET)
unnamed: R23.1, U8.8 (EN)
POX_INT: U1.2 (P1.01); also elsewhere on the board
SCL: R1.2, U1.4 (P1.03); also elsewhere on the board
SDA: R2.2, U1.3 (P1.02); also elsewhere on the board
SPI_CLK: U1.12 (P2.01); also elsewhere on the board
SPI_CS: U1.16 (P2.05); also elsewhere on the board
SPI_MISO: U1.15 (P2.04); also elsewhere on the board
SPI_MOSI: U1.13 (P2.02); also elsewhere on the board
USER_BUTTON: U1.41 (P1.13); also elsewhere on the board
VBATT_SENSE: U1.8 (P1.07); also elsewhere on the board
n70_COEX_GRANT: U1.21 (P2.10); also elsewhere on the board
n70_COEX_REQ: U1.20 (P2.09); also elsewhere on the board
n70_COEX_STATUS0: U1.18 (P2.07); also elsewhere on the board
n70_COEX_STATUS1: U1.19 (P2.08); also elsewhere on the board
n70_HOST_IRQ: U1.17 (P2.06); also elsewhere on the board
n70_SW_CTRL0: U1.14 (P2.03); also elsewhere on the board

Notes on the sheet:
Note: Want this to be a right angle connector to save space

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
Board: 2 copper layers, 101 parts (0 on the bottom side), 66 nets, no tracks yet.

Other parts of the board:
D4#2: WS2812B; LED_WS2812B_PLCC4_5.0x5.0mm_P3.2mm

Their connections:
3V3: D4#2.1 (VDD); also elsewhere on the board
GND: D4#2.3 (VSS); also elsewhere on the board
