Bafran/fall-detection-capstone/software/fall_detection/chest/chest.ino

#include <Wire.h>
#include "esp_timer.h"
#include <Adafruit_LSM6DSOX.h>
#include <math.h>
#include <esp_now.h>
#include <WiFi.h>
#include <WiFiUdp.h>
#include "../fall_detection/secrets.h"

// Chest Master script and Wrist data receiver 

Adafruit_LSM6DSOX lsm6ds;

// ESP Now wrist message structure
typedef struct __attribute__((packed)) {
  float ax, ay, az;
  float gx, gy, gz;
  uint32_t batt_mv;
  uint32_t curr_mA;
} WristMsg;

volatile WristMsg wristData;
volatile int64_t last_wrist_rx_us = 0;

// Pins
#define USER_LED 10
#define SDA_PIN 3
#define SCL_PIN 8
#define USER_BTN 9
#define V_BATT_SENSE_PIN 0
#define CURR_SENSE_PIN 1

// Manual fall trigger
bool btn_pressed = false;
int64_t btn_press_start_us = 0;
const int64_t MANUAL_TRIGGER_US = 5000000; // 5 seconds

// Double-press cancel
uint8_t short_press_count = 0;
int64_t last_short_press_release_us = 0;
const int64_t DOUBLE_PRESS_WINDOW_US = 1000000; // 1 second between presses

// Track whether an alert has been raised
bool alert_active = false;

// Sampling Rate
const uint32_t SAMPLE_PERIOD_MS = 10; // ~100 Hz

// UDP fall event reporting (to Python server_ui.py)
const uint16_t SERVER_PORT = 9000;
WiFiUDP udp;
const char* DEVICE_ID = "chest";

// Helper Functions 
static inline float mag3f(float x, float y, float z) {
  return sqrtf(x*x + y*y + z*z);
}

// Fall Detection State Machine
enum FallState { FD_IDLE, FD_IMPACT_DETECTED };
FallState fall_state = FD_IDLE;

int64_t impact_time_us = 0;
int64_t chest_still_start_us = 0;

const float G = 9.81f;

// Impact trigger thresholds (chest)
const float IMPACT_A_THR = 25.0f;        // m/s^2
const float IMPACT_W_THR = 6.0f;         // rad/s
const float GYRO_IMPACT_A_MIN = 11.0f;   // if gyro triggers, require some accel too

// Chest stillness to qualify as candidate fall
const float CHEST_STILL_W_THR  = 1.0f;   // rad/s
const float CHEST_STILL_A_BAND = 2.0f;   // m/s^2
const int64_t CHEST_STILL_US   = 1500000;

// Guards
const int64_t TIMEOUT_US = 6000000;
const int64_t STARTUP_IGNORE_US = 2000000;

// Debouncing impact
uint8_t impact_hits = 0;
const uint8_t IMPACT_HITS_REQUIRED = 3;

// Verification states  
bool verifying = false;
int64_t verify_start_us = 0;

// Verify timing
const int64_t VERIFY_TIMEOUT_US = 12000000;

// Wrist packet freshness
const int64_t WRIST_RX_TIMEOUT_US = 800000;

// Stillness thresholds (tune this later)
const float CHEST_VERIFY_W_THR  = 2.0f;
const float WRIST_VERIFY_W_THR  = 2.5f;

const float CHEST_VERIFY_A_BAND = 3.5f;
const float WRIST_VERIFY_A_BAND = 4.0f;

// Score accumulator: increments when BOTH still, decays when not
int32_t verify_still_score = 0;
const int32_t VERIFY_SCORE_REQ = 500;   // confirm once we reach this
const int32_t SCORE_INC = 1;            // +1 each sample both still
const int32_t SCORE_DEC = 1;            // -1 each sample not both still
const int32_t SCORE_MAX = 700;          // cap (prevents runaway)

// ESP-NOW receive callback
void OnDataRecv(const esp_now_recv_info_t *info, const uint8_t *incomingData, int len) {
  if (len == (int)sizeof(WristMsg)) {
    memcpy((void*)&wristData, incomingData, sizeof(WristMsg));
    last_wrist_rx_us = esp_timer_get_time();
  }
}

const char* fallStateToString() {
  if (verifying) return "VERIFYING";

  switch (fall_state) {
    case FD_IDLE:
      return "IDLE";
    case FD_IMPACT_DETECTED:
      return "IMPACT_DETECTED";
    default:
      return "UNKNOWN";
  }
}

static void sendUdpEvent(
  const char* event_type,
  int64_t t_us,
  float chest_a_mag,
  float chest_w_mag,
  uint32_t chest_batt_mv,
  uint32_t chest_curr_mA,
  uint32_t wrist_batt_mv,
  uint32_t wrist_curr_mA
) {
  if (WiFi.status() != WL_CONNECTED) return;

  char eventbuf[220];
  int en = snprintf(
    eventbuf, sizeof(eventbuf),
    "event,%s,%s,%lld,%.2f,%.2f,%lu,%lu,%lu,%lu",
    event_type,
    DEVICE_ID,
    (long long)t_us,
    chest_a_mag,
    chest_w_mag,
    (unsigned long)chest_batt_mv,
    (unsigned long)chest_curr_mA,
    (unsigned long)wrist_batt_mv,
    (unsigned long)wrist_curr_mA
  );

  if (en > 0) {
    udp.beginPacket(SERVER_IP, SERVER_PORT);
    udp.write((uint8_t*)eventbuf, en);
    udp.endPacket();
  }
}

static void clearAlertState() {
  fall_state = FD_IDLE;
  verifying = false;
  impact_hits = 0;
  chest_still_start_us = 0;
  impact_time_us = 0;
  verify_still_score = 0;
  alert_active = false;
}

void setup() {
  pinMode(USER_LED, OUTPUT);
  pinMode(USER_BTN, INPUT_PULLUP);
  digitalWrite(USER_LED, HIGH);

  Serial.begin(115200);
  delay(500);

  analogSetPinAttenuation(V_BATT_SENSE_PIN, ADC_6db);
  analogSetPinAttenuation(CURR_SENSE_PIN, ADC_11db);

  // WiFi + ESP-NOW init
  WiFi.mode(WIFI_STA);
  Serial.println("Connecting to WiFi...");
  WiFi.begin(WIFI_SSID, WIFI_PASS);
  uint8_t wifi_attempts = 0;
  while (WiFi.status() != WL_CONNECTED && wifi_attempts < 40) {
    delay(250);
    wifi_attempts++;
  }
  if (WiFi.status() == WL_CONNECTED) {
    Serial.print("WiFi connected, IP=");
    Serial.println(WiFi.localIP());
  } else {
    Serial.println("WiFi connect failed, continuing with ESP-NOW only");
  }

  if (esp_now_init() != ESP_OK) {
    Serial.println("ESP-NOW init failed");
    while (1) { delay(500); }
  }
  esp_now_register_recv_cb(OnDataRecv);
  Serial.println("ESP-NOW receiver ready");

  // Chest IMU init
  Wire.begin(SDA_PIN, SCL_PIN);
  if (!lsm6ds.begin_I2C(LSM6DS_I2CADDR_DEFAULT, &Wire)) {
    Serial.println("Chest IMU not found!");
    while (1) { delay(500); }
  }

  lsm6ds.setAccelRange(LSM6DS_ACCEL_RANGE_16_G);
  lsm6ds.setGyroRange(LSM6DS_GYRO_RANGE_2000_DPS);
  lsm6ds.setAccelDataRate(LSM6DS_RATE_104_HZ);
  lsm6ds.setGyroDataRate(LSM6DS_RATE_104_HZ);

  Serial.println("Chest fall detector ready.");
  Serial.println("Flow: impact -> chest still(1.5s) -> VERIFY score (both still ~5s total)");
}

void loop() {

  static uint32_t last_led_toggle_ms = 0;
  static bool led_state = false;
  
  uint32_t now_ms = millis();

  // Toggle LED
  if (now_ms - last_led_toggle_ms >= 500) {
    last_led_toggle_ms = now_ms;
    led_state = !led_state;
    digitalWrite(USER_LED, led_state ? HIGH : LOW);
  }

  static uint32_t last_sample_ms = 0;
  static uint32_t last_debug_ms = 0;
  static uint32_t last_verify_dbg_ms = 0;
  static uint32_t last_status_udp_ms = 0;

  if (now_ms - last_sample_ms < SAMPLE_PERIOD_MS) return;
  last_sample_ms += SAMPLE_PERIOD_MS;

  int64_t t_us = esp_timer_get_time();

  // Read the chest IMU
  sensors_event_t accel, gyro, temp;
  lsm6ds.getEvent(&accel, &gyro, &temp);

  float chest_a_mag = mag3f(accel.acceleration.x, accel.acceleration.y, accel.acceleration.z);
  float chest_w_mag = mag3f(gyro.gyro.x, gyro.gyro.y, gyro.gyro.z);

  uint32_t v_batt_sense_raw_mv = analogReadMilliVolts(V_BATT_SENSE_PIN);
  uint32_t v_batt_mv = v_batt_sense_raw_mv * 3;   // 200k / 100k divider

  uint32_t curr_sense_raw_mv = analogReadMilliVolts(CURR_SENSE_PIN);
  uint32_t curr_sense_mA = curr_sense_raw_mv / 5; // 5 mV per mA

  // Copy the wrist data
  WristMsg w;
  memcpy(&w, (const void*)&wristData, sizeof(WristMsg));
  int64_t wrist_rx_age_us = t_us - last_wrist_rx_us;

  float wrist_a_mag = mag3f(w.ax, w.ay, w.az);
  float wrist_w_mag = mag3f(w.gx, w.gy, w.gz);

  // Ignoring Startup readings for 2 seconds to allow sensor stabilization
  if (t_us < STARTUP_IGNORE_US) {
    fall_state = FD_IDLE;
    verifying = false;
    impact_hits = 0;
    chest_still_start_us = 0;
    verify_still_score = 0;
    return;
  }

  bool btn_state = digitalRead(USER_BTN);

  // Button pressed
  if (btn_state == LOW && !btn_pressed) {
    btn_pressed = true;
    btn_press_start_us = t_us;
  }

  // Button released
  if (btn_state == HIGH && btn_pressed) {
    int64_t press_duration_us = t_us - btn_press_start_us;
    btn_pressed = false;

    // Ignore long holds here because those are handled by manual trigger
    if (press_duration_us < MANUAL_TRIGGER_US) {
      bool cancellable_state =
        alert_active || verifying || (fall_state != FD_IDLE);

      if (cancellable_state) {
        if (short_press_count == 0) {
          short_press_count = 1;
          last_short_press_release_us = t_us;
        } else if ((t_us - last_short_press_release_us) <= DOUBLE_PRESS_WINDOW_US) {
          Serial.println(">>> ALERT CLEARED BY DOUBLE PRESS");

          clearAlertState();

          sendUdpEvent(
            "alert_cleared",
            t_us,
            chest_a_mag,
            chest_w_mag,
            v_batt_mv,
            curr_sense_mA,
            w.batt_mv,
            w.curr_mA
          );

          short_press_count = 0;
        } else {
          short_press_count = 1;
          last_short_press_release_us = t_us;
        }
      } else {
        short_press_count = 0;
      }
    }
  }

  // Expire first short press if second one never comes
  if (short_press_count == 1 && (t_us - last_short_press_release_us) > DOUBLE_PRESS_WINDOW_US) {
    short_press_count = 0;
  }

  // If button held long enough -> trigger manual fall
  if (btn_pressed && (t_us - btn_press_start_us >= MANUAL_TRIGGER_US)) {
    Serial.println(">>> MANUAL FALL TRIGGER (5s hold)");

    sendUdpEvent(
      "manual_trigger",
      t_us,
      chest_a_mag,
      chest_w_mag,
      v_batt_mv,
      curr_sense_mA,
      w.batt_mv,
      w.curr_mA
    );

    alert_active = true;

    // prevent retrigger while still holding
    btn_pressed = false;
    short_press_count = 0;
  }

  // Chest candidate detection
  if (!verifying) {
    switch (fall_state) {
      case FD_IDLE: {
        bool impact_now =
          (chest_a_mag > IMPACT_A_THR) ||
          ((chest_w_mag > IMPACT_W_THR) && (chest_a_mag > GYRO_IMPACT_A_MIN));

        if (impact_now) impact_hits++;
        else impact_hits = 0;

        if (impact_hits >= IMPACT_HITS_REQUIRED) {
          impact_hits = 0;
          fall_state = FD_IMPACT_DETECTED;
          impact_time_us = t_us;
          chest_still_start_us = 0;
          Serial.println(">>> CHEST IMPACT DETECTED");
        }
        break;
      }

      case FD_IMPACT_DETECTED: {
        bool chest_still =
          (chest_w_mag < CHEST_STILL_W_THR) &&
          (fabsf(chest_a_mag - G) < CHEST_STILL_A_BAND);

        if (chest_still) {
          if (chest_still_start_us == 0) chest_still_start_us = t_us;
        } else {
          chest_still_start_us = 0;
        }

        if (chest_still_start_us != 0 && (t_us - chest_still_start_us) >= CHEST_STILL_US) {
          Serial.println("***** CHEST FALL CANDIDATE -> START VERIFY *****");

          verifying = true;
          verify_start_us = t_us;
          verify_still_score = 0;

          Serial.print("VERIFY START t_us=");
          Serial.println((long long)verify_start_us);

          fall_state = FD_IDLE;
          return;
        }

        if ((t_us - impact_time_us) > TIMEOUT_US) {
          Serial.println("Impact cancelled (chest timeout)");
          fall_state = FD_IDLE;
          chest_still_start_us = 0;
          impact_hits = 0;
          return;
        }

        break;
      }
    }
  }

  // Verification Stage using a score based stillness
  if (verifying) {
    bool wrist_fresh = (wrist_rx_age_us >= 0) && (wrist_rx_age_us < WRIST_RX_TIMEOUT_US);

    bool chest_still_verify =
      (chest_w_mag < CHEST_VERIFY_W_THR) &&
      (fabsf(chest_a_mag - G) < CHEST_VERIFY_A_BAND);

    bool wrist_still_verify =
      wrist_fresh &&
      (wrist_w_mag < WRIST_VERIFY_W_THR) &&
      (fabsf(wrist_a_mag - G) < WRIST_VERIFY_A_BAND);

    bool both_still = chest_still_verify && wrist_still_verify;

    // Score update
    if (both_still) {
      verify_still_score += SCORE_INC;
      if (verify_still_score > SCORE_MAX) verify_still_score = SCORE_MAX;
    } else {
      verify_still_score -= SCORE_DEC;
      if (verify_still_score < 0) verify_still_score = 0;
    }

    // Confirm
    if (verify_still_score >= VERIFY_SCORE_REQ) {
      Serial.print("######## FALL CONFIRMED ######## elapsed_s=");
      Serial.print((t_us - verify_start_us) / 1000000.0, 3);
      Serial.print("  score=");
      Serial.println(verify_still_score);

      sendUdpEvent(
        "fall_confirmed",
        t_us,
        chest_a_mag,
        chest_w_mag,
        v_batt_mv,
        curr_sense_mA,
        w.batt_mv,
        w.curr_mA
      );

      alert_active = true;

      verifying = false;
      verify_still_score = 0;
      return;
    }

    // Timeout
    if ((t_us - verify_start_us) > VERIFY_TIMEOUT_US) {
      Serial.print("VERIFY TIMEOUT (not confirmed) -- elapsed_s=");
      Serial.print((t_us - verify_start_us) / 1000000.0, 3);
      Serial.print("  score=");
      Serial.println(verify_still_score);

      verifying = false;
      verify_still_score = 0;
      return;
    }

    // Once a second verify debug using DEVICE TIME
    if (now_ms - last_verify_dbg_ms >= 1000) {
      last_verify_dbg_ms = now_ms;

      Serial.print("[VERIFY] elapsed_s=");
      Serial.print((t_us - verify_start_us) / 1000000.0, 3);
      Serial.print(" score=");
      Serial.print(verify_still_score);
      Serial.print(" chestStill=");
      Serial.print(chest_still_verify ? "Y" : "N");
      Serial.print(" wristStill=");
      Serial.print(wrist_still_verify ? "Y" : "N");
      Serial.print(" wristAgeMs=");
      Serial.print((long)(wrist_rx_age_us / 1000));
      Serial.print(" wrist|a|=");
      Serial.print(wrist_a_mag, 2);
      Serial.print(" wrist|w|=");
      Serial.print(wrist_w_mag, 2);
      Serial.print(" chest|a|=");
      Serial.print(chest_a_mag, 2);
      Serial.print(" chest|w|=");
      Serial.println(chest_w_mag, 2);
    }
  }

  // Regular debug (1 Hz)
  if (now_ms - last_debug_ms >= 1000) {
    last_debug_ms = now_ms;

    Serial.print("Chest |a|=");
    Serial.print(chest_a_mag, 2);
    Serial.print(" |w|=");
    Serial.print(chest_w_mag, 2);

    Serial.print("  Wrist |a|=");
    Serial.print(wrist_a_mag, 2);
    Serial.print(" |w|=");
    Serial.print(wrist_w_mag, 2);

    Serial.print("  verifying=");
    Serial.print(verifying ? "yes" : "no");

    Serial.print("  Chest Batt=");
    Serial.print(v_batt_mv);
    Serial.print("mV");

    Serial.print("  Chest Curr=");
    Serial.print(curr_sense_mA);
    Serial.print("mA");

    Serial.print("  Wrist Batt=");
    Serial.print(w.batt_mv);
    Serial.print("mV");

    Serial.print("  Wrist Curr=");
    Serial.print(w.curr_mA);
    Serial.println("mA");
  }

  // Periodic UDP status send (1 per 30 seconds
  if (WiFi.status() == WL_CONNECTED && now_ms - last_status_udp_ms >= 30000) {
    last_status_udp_ms = now_ms;

    bool wrist_fresh = (wrist_rx_age_us >= 0) && (wrist_rx_age_us < WRIST_RX_TIMEOUT_US);

    char statusbuf[256];
    int sn = snprintf(
      statusbuf, sizeof(statusbuf),
      "status,%s,%lld,%s,%lu,%lu,%lu,%lu,%d,%.2f,%.2f,%.2f,%.2f",
      DEVICE_ID,
      (long long)t_us,
      fallStateToString(),
      (unsigned long)v_batt_mv,      // chest battery
      (unsigned long)curr_sense_mA,  // chest current
      (unsigned long)w.batt_mv,      // wrist battery
      (unsigned long)w.curr_mA,      // wrist current
      wrist_fresh ? 1 : 0,           // wrist packet fresh?
      chest_a_mag,
      chest_w_mag,
      wrist_a_mag,
      wrist_w_mag
    );

    if (sn > 0) {
      udp.beginPacket(SERVER_IP, SERVER_PORT);
      udp.write((uint8_t*)statusbuf, sn);
      udp.endPacket();
    }
  }
}
