Bafran/fall-detection-capstone/(commit log)

2025-11-15 KiCAD MCU initial commit
    [bracelet_rev1.kicad_pcb, bracelet_rev1.kicad_sch]
2025-11-15 Empty ESP32 file
2025-11-15 Copy Adafruit example code for IMU
2025-11-18 Changed IMU test code
2025-11-18 Add IMU to schematic
    [bracelet_rev1.kicad_sch]
2025-11-19 Added power. It is a mess
    [bracelet_rev1.kicad_sch]
2025-11-20 Organize schematic a bit
    [bracelet_rev1.kicad_sch, nRF.kicad_sch, peripherals.kicad_sch, power_management.kicad_sch]
2025-11-22 Many schematic updates
    [bracelet_rev1.kicad_sch, nRF.kicad_sch, peripherals.kicad_sch, power_management.kicad_sch]
2025-11-23 Mostly finihsed hopefully but still needs clean up anyway
    [bracelet_rev1.kicad_sch, nRF.kicad_sch, peripherals.kicad_sch, power_management.kicad_sch]
2025-12-03 May updates
    [bracelet_rev1.kicad_pcb, bracelet_rev1.kicad_sch, nRF.kicad_sch, peripherals.kicad_sch, power_management.kicad_sch, untitled.kicad_sch]
2025-12-03 Redo component numbers
    [bracelet_rev1.kicad_sch, nRF.kicad_sch, peripherals.kicad_sch, power_management.kicad_sch, untitled.kicad_sch]
2025-12-19 Updated Wi-Fi IC
    [SMV_z90.stp, untitled.kicad_sch]
2025-12-19 Setting up nRF54 pinout
    [untitled.kicad_sch]
2025-12-20 Updated more things
    [nRF.kicad_sch, peripherals.kicad_sch, power_management.kicad_sch]
2025-12-21 More schematic stuff
    [bracelet_rev1.kicad_pcb, nRF.kicad_sch, peripherals.kicad_sch, power_management.kicad_sch, untitled.kicad_sch]
2025-12-22 ESP32 Sensor Module Schematic
    [10LGA_2X2X0p75_BOS.step, esp_module_rev1.kicad_pcb, esp_module_rev1.kicad_sch]
2025-12-23 Layout attempt
    [esp_module_rev1.kicad_pcb, esp_module_rev1.kicad_sch]
2025-12-23 Layout attempt two. Routing started
    [esp_module_rev1.kicad_pcb, esp_module_rev1.kicad_sch]
2025-12-23 Routing mostly done i think
    [esp_module_rev1.kicad_pcb]
2025-12-26 Responding to comments
    [esp_module_rev1.kicad_pcb, esp_module_rev1.kicad_sch]
2025-12-26 Revised USB layout and ground pour on bottom layer
    [esp_module_rev1.kicad_pcb]
2025-12-26 Trace is no longer broken
    [esp_module_rev1.kicad_pcb]
2026-01-17 Pushing unsaved changes
    [bom.csv, designators.csv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]
2026-01-27 Updated IMU test code
2026-02-01 moved imu_test into sketch folder
2026-02-01 deleting old imu_test out of sketch folder
2026-02-01 esp-now connection between boards
2026-02-17 wirst ino added
2026-03-10 Added Battery Sensing and UDP receiver to web server
2026-03-10 Cancellation Button
